AntidotRepository/Quadrirotor/présentation/DIAPO FINAL.pptx

## Réalisation d’un quadricoptère

- Projets tuteurés – Licence Pro Systèmes embarqués

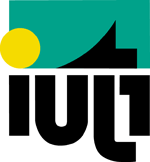
[picture p33: figure]
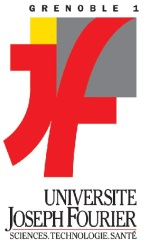
[picture p34: figure]
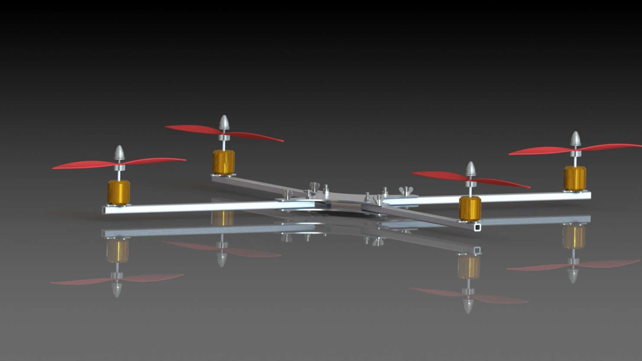
[picture p35: figure]

Harold DUCEPT

2013 - 2014

Lpro SE

## Introduction

1. Comment se déroulent les mini-projets?
  1. Durée de 100h
  2. Travail en autonomie
2. Pourquoi faire un quadricoptère?
  1. Faire du modélisme
  2. Faire quelque chose qui vol
  3. Faire de belles prises de vue
3. Pourquoi le faire pendant les projets tuteurés?
  1. Voué à l’abandon dans le cas contraire
  2. Me permet d’être sur un projet sur lequel je suis motivé

## Sommaire

1. Organisation du système
  1. Les différents sous-ensemble et leur utilité
  2. L’organisation de ces CU à l’aide d’un OS.
2. Etat du système au début du projet tuteuré
  1. Partie PC
  2. Partie Embarquée
3. Avancement
  1. Gyroscope
  2. Altimètre
  3. Moteurs
4. Etat du projet à la fin
  1. Partie PC
  2. Partie embarquée
5. Conclusion

## 1. Organisation du système

- Les différents sous-ensembles

Station sol

DRONE

Système Embarquée

Organisation du système - Les différents sous-ensemble et leur utilité | Etat du système | Avancement | Etat du projet à la fin | Conclusion

## Les différents sous-ensembles

- Station sol

Système réception vidéo

Ecran

Commande

Station sol

Joystick / clavier / souris

XBee

Organisation du système - Les différents sous-ensemble et leur utilité | Etat du système | Avancement | Etat du projet à la fin | Conclusion

## Les différents sous-ensembles

- Partie Embarquée

Batterie

Organisation du système - Les différents sous-ensemble et leur utilité | Etat du système | Avancement | Etat du projet à la fin | Conclusion

µ-contrôleur

Boussole

XBee

PCB

Gyroscope

Altimètre

Variateur

Moteurs

Armature

Partie Embarquée

Partie mécanique

Hélices

Système Vidéo

Caméra

Système émission

Antenne

## Organisation des CUs à l’aide d’un OS

- Pourquoi utiliser un OS?
  - Faire tourner en parallèle des morceaux de code indépendants
  - Avoir une couche d’abstraction matériel
  - Code portable sur tout les microcontrôleurs où le portage de l’OS à été réalisé
- Pourquoi utiliser ChibiOS?
  - Code compatible avec le microcontrôleur que je possède
  - Développé avec un IDE gratuit et que je connais

Organisation du système - L’organisation de ces CU à l’aide d’un OS| Etat du système | Avancement | Etat du projet à la fin | Conclusion

## Organisation des CUs à l’aide d’un OS

ThreadComRcv

ThreadRoulisTangage

ThreadComSnd

Thread principal

ThreadAltitude

ThreadLacet

Organisation du système - L’organisation de ces CU à l’aide d’un OS| Etat du système | Avancement | Etat du projet à la fin | Conclusion

## 2. Etat du système au début du projet

- Partie PC
  - ToDo List:
    - Interface graphique
    - Réception et décodage des trames
    - Codage et envoi des trames
    - Gestion des évènements
    - Recommencer la partie PC…

Organisation du système | Etat du système - Partie PC| Avancement | Etat du projet à la fin | Conclusion

## Etat du système au début du projet

- Partie embarquée
  - ToDo List:
    - Implantation de l’OS
    - Paramétrer un bus I²C
    - Gérer la position du quadricoptère
    - Gérer l’altitude du quadricoptère
    - Réaliser une liaison série sans fil pour envoyer et recevoir des données entre le PC et le quadricoptère
    - Choisir et mettre en place les sorties moteurs
    - Faire une structure et un PCB
    - Rechercher et mettre en place les équations permettant la stabilisation du système
    - Rechercher et mettre en place les équations permettant le filtrage des données

Organisation du système | Etat du système - Partie embarquée| Avancement | Etat du projet à la fin | Conclusion

## 3. Avancement du projet durant les 100h

- Gyroscope
  - Utilité?
    - Permet la gestion du tangage, du roulis et du lacet
  - Modèle choisi
    - MPU-6050 à 2,98€: Gyroscope 6 axes: 3 angles + 3 accélérations
    - Fonctionne sur bus I²C, alimenté en 3,3V ou 5V

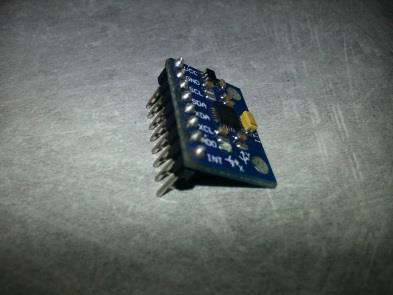
[picture p36: figure]
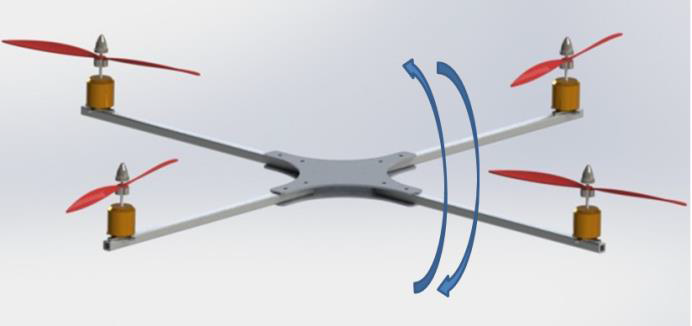
[picture p37: figure]
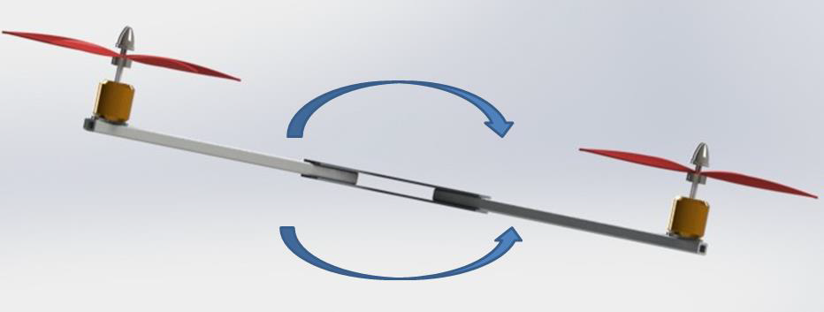
[picture p38: figure]
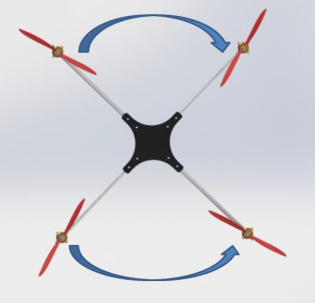
[picture p39: figure]

Organisation du système | Etat du système | Avancement - Gyroscope| Etat du projet à la fin | Conclusion

## Avancement du projet durant les 100h

- Gyroscope
  - Fonctionnement:
  - Conversion de l’angle:

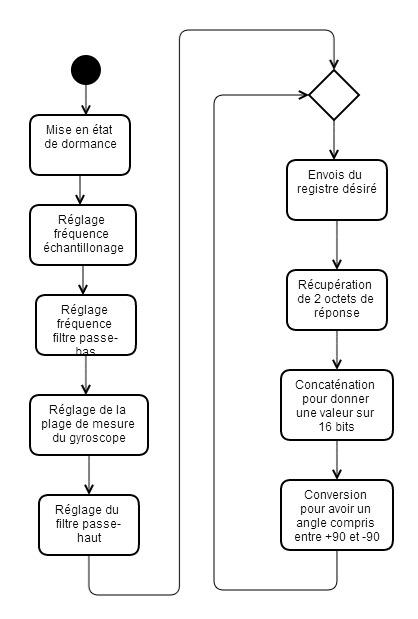
[picture p40: figure]

Si angle compris entre 49151(0xBFFF) et 65535(0xFFFF):
angle en degré= (angle brute −0xBFFF)/(0xB6)−0x5A
Sinon, si angle compris entre 0(0x0000) et 16384(0x4000):
angle en degré= (angle brute)/(0xB6)
Sinon:
angle en degré=0

Organisation du système | Etat du système | Avancement - Gyroscope| Etat du projet à la fin | Conclusion


## Avancement du projet durant les 100h

- Gyroscope
  - Difficultés rencontrées:
    - Paramétrage de l’I²C laborieux
    - Impossible de récupérer un angle de lacet correct.
    - Documentation ne fournissant pas les informations nécessaires.
    - Basé sur un code de démonstration pas forcément bien expliqué (en chinois…)

Organisation du système | Etat du système | Avancement - Gyroscope| Etat du projet à la fin | Conclusion

## Avancement du projet durant les 100h

- Capteur de pression atmosphérique
  - Utilité
    - Connaître l’altitude du quadricoptère en se basant sur la pression atmosphérique.
  - Modèle choisi
    - BMP085 à 9,64€: Capteur de pression atmosphérique d’une précision d’environ 25 cm.
    - Fonctionne sur bus I²C, alimenté en 3,3V ou 5V.

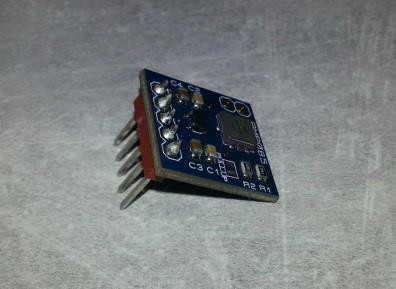
[picture p41: figure]
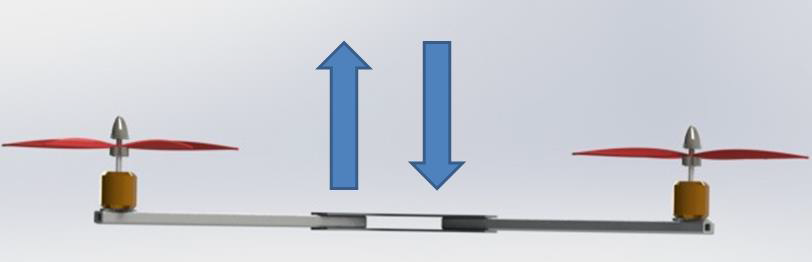
[picture p42: figure]

Organisation du système | Etat du système | Avancement - Altimètre| Etat du projet à la fin | Conclusion

## Avancement du projet durant les 100h

- Capteur de pression atmosphérique
  - Fonctionnement:
  - Difficultés rencontrées
    - Problème d’allocation mémoire avec l’OS
    - Problème optimisation compilateur
    - Algorithme compliqué à mettre en place pour convertir la pression atmosphérique en altitude

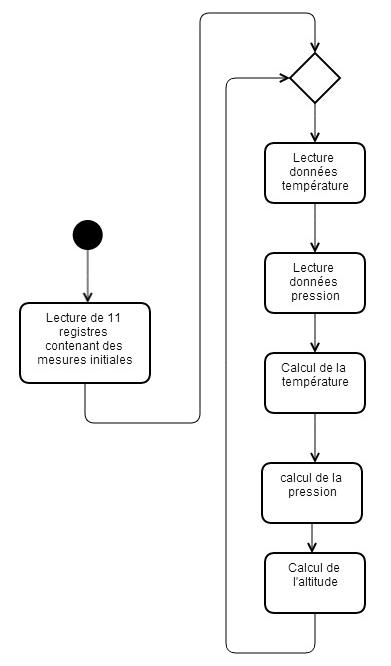
[picture p43: figure]

Organisation du système | Etat du système | Avancement - Altimètre| Etat du projet à la fin | Conclusion

## Avancement du projet durant les 100h

- Moteurs
  - Utilité
    - Les moteurs permettent d’entrainer les hélices.
    - Commandés par le biais de variateurs
  - Modèle choisi
    - Moteurs:
    - Moteurs NTM brushless 1100kv – 20A max – 57g
    - Variateur:
    - Variateur Qbrain 4x25A (4 variateurs dans un seul bloc)
    - Batterie:
    - Batterie LiPo Turnigy 3300mAh 25-50C 4 Cellules – 14,8V
    - Hélices:
    - 10x4,5 pouces: 2 sens horaire, 2 sens trigo

Organisation du système | Etat du système | Avancement - Moteurs| Etat du projet à la fin | Conclusion

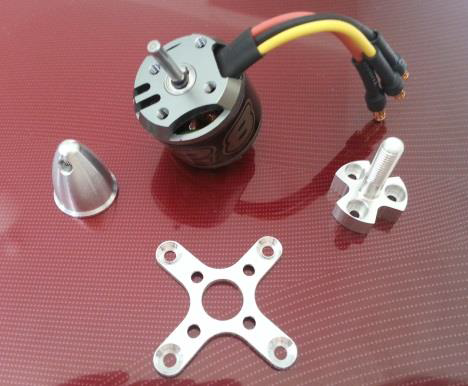
[picture p44: figure]
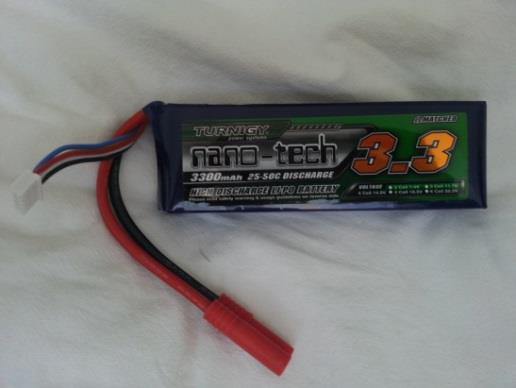
[picture p45: figure]
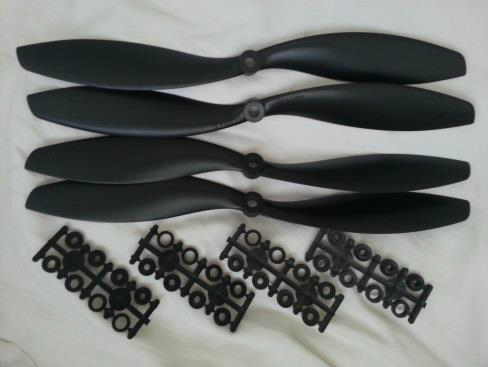
[picture p46: figure]
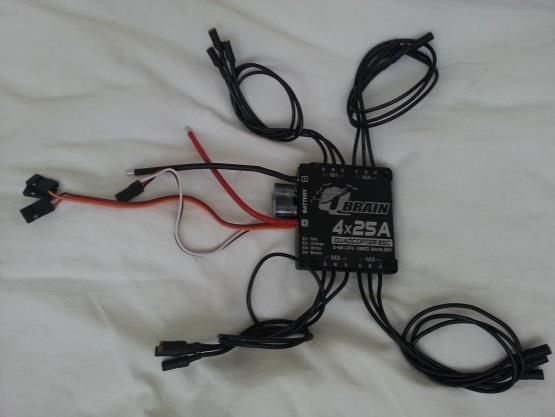
[picture p47: figure]

## Avancement du projet durant les 100h

- Moteurs
  - Hardware:
  - Fonctionnement:
  - Difficultés rencontrées:
    - Absence de documentation concernant le variateur -> compliqué de savoir comment les démarrer.

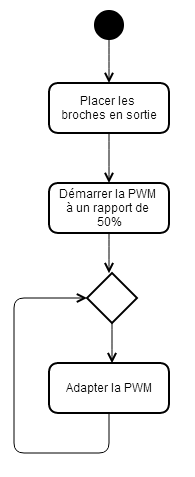
[picture p48: figure]
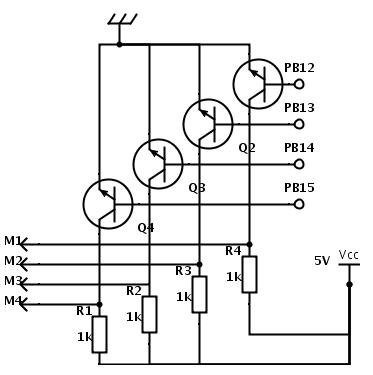
[picture p49: figure]

Organisation du système | Etat du système | Avancement - Moteurs| Etat du projet à la fin | Conclusion

## 3. Etat du projet à la fin des 100h

- Partie PC
  - ToDo List:
    - Interface graphique
    - Réception et décodage des trames
    - Codage et envoi des trames
    - Gestion des évènements
    - Recommencer la partie PC…

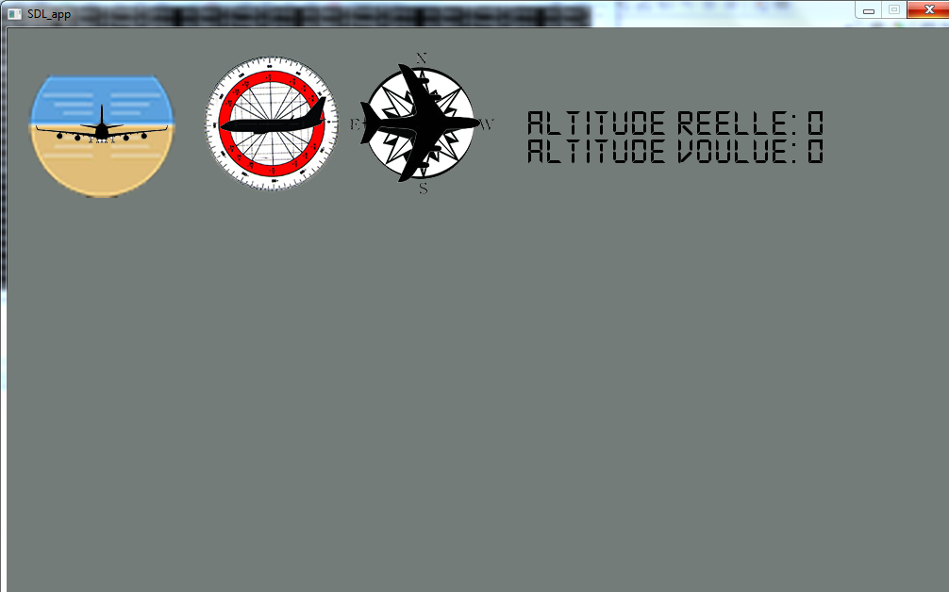
[picture p50: figure]

Organisation du système | Etat du système | Avancement - Moteurs| Etat du projet à la fin – partie PC | Conclusion

## Etat du projet à la fin

- Partie embarquée
  - ToDo List:
    - Implantation de l’OS
    - Paramétrer un bus I²C
    - Gérer la position du quadricoptère
    - Gérer l’altitude du quadricoptère
    - Coder et envoyer sur une liaison série la position du quadricoptère
    - Recevoir et décoder la position désirée du quadricoptère
    - Choisir et mettre en place les sorties moteurs
    - Faire une structure et un PCB
    - Rechercher et mettre en place les équations permettant la stabilisation du système
    - Rechercher et mettre en place les équations permettant le filtrage des données

Organisation du système | Etat du système | Avancement - Moteurs| Etat du projet à la fin – partie embarquée | Conclusion

## Conclusion

- Permis d’avancer sur un projet voué à l’échec dans le cas contraire
- Revoir des notions vues en cours
- Découvrir un nouvel OS
- Développer mes capacités de débogage
- Confirmer mon choix de vouloir travailler dans l’embarqué

Organisation du système | Etat du système | Avancement - Moteurs| Etat du projet à la fin | Conclusion

## Slide 21

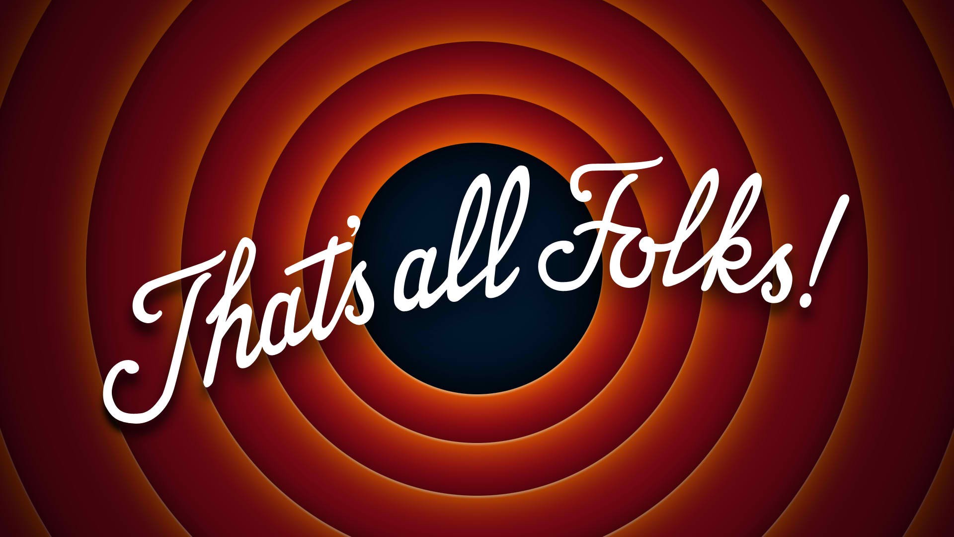
[picture p51: figure]
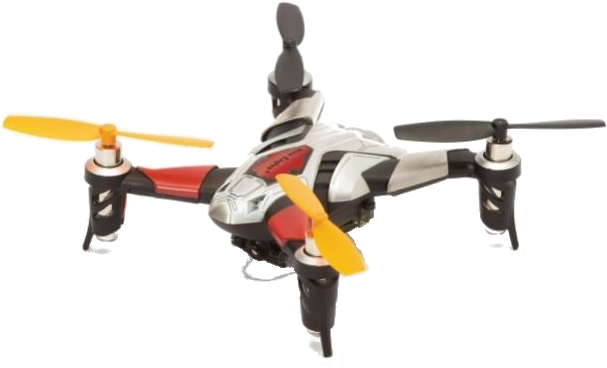
[picture p52: figure]
