AntidotRepository/Quadrirotor/compte rendu/altitude.JPG

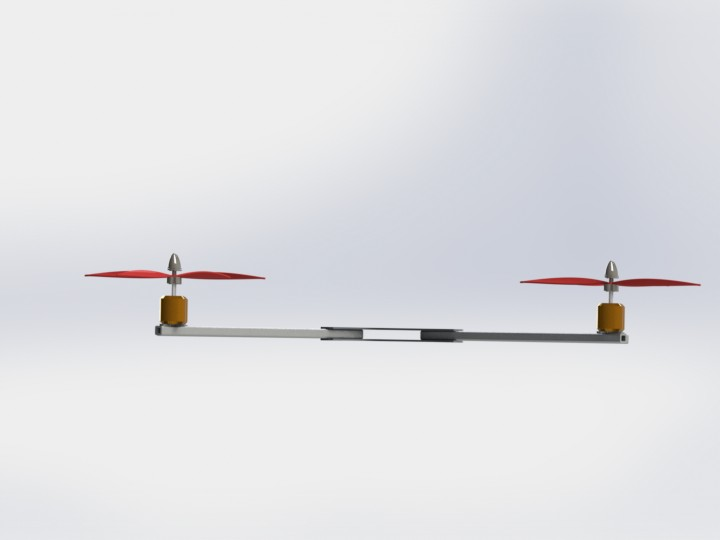
compte rendu/altitude.JPG
