AntidotRepository/Quadrirotor/compte rendu/cu_quadri.jpg

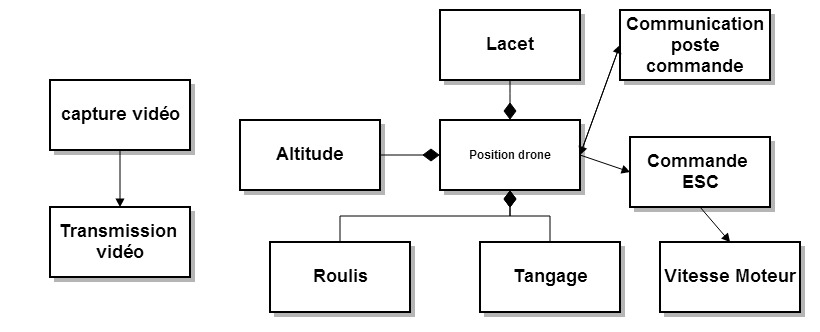
compte rendu/cu_quadri.jpg
