AntidotRepository/Quadrirotor/compte rendu/diagramme déploiement matériel.jpg

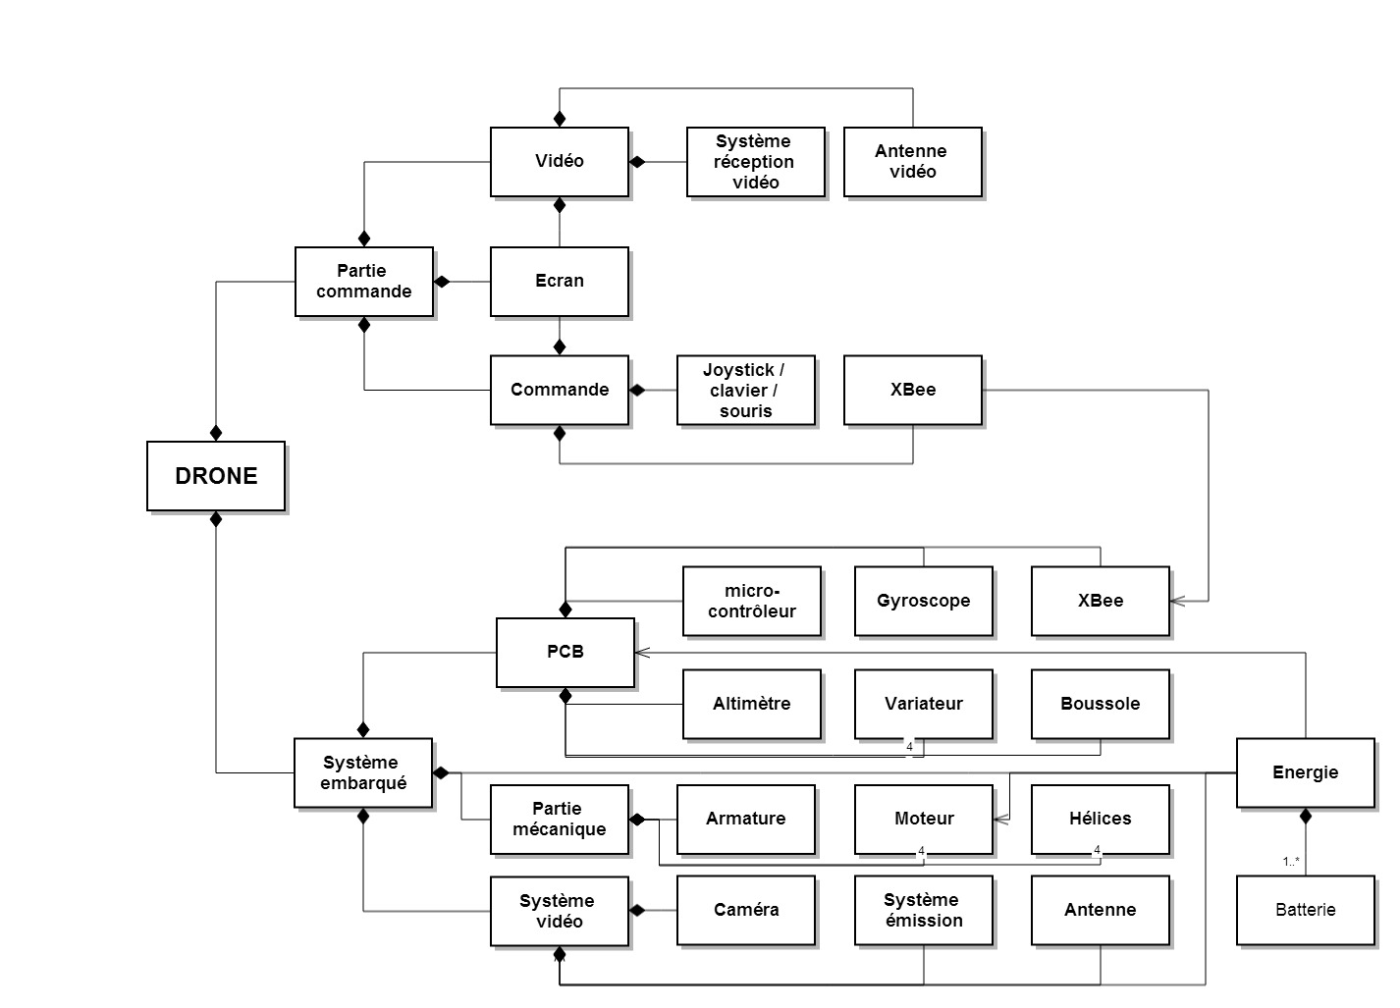
compte rendu/diagramme déploiement matériel.jpg
