AntidotRepository/Quadrirotor/compte rendu/lacet.JPG

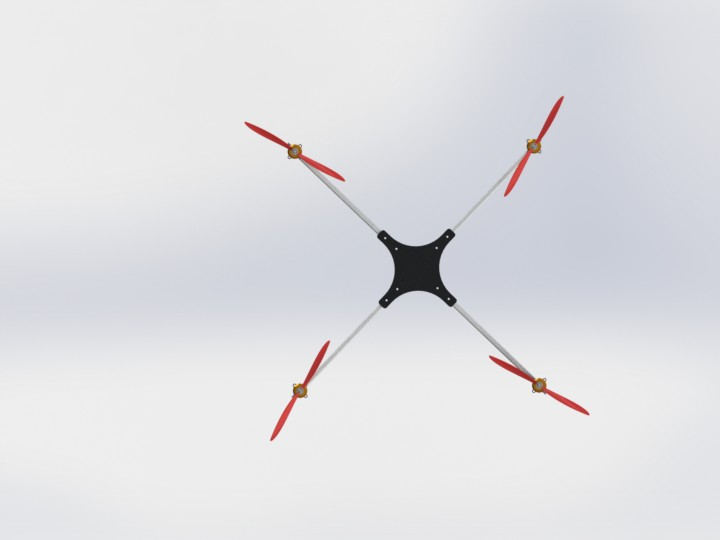
compte rendu/lacet.JPG
