AntidotRepository/Quadrirotor/compte rendu/quad.JPG

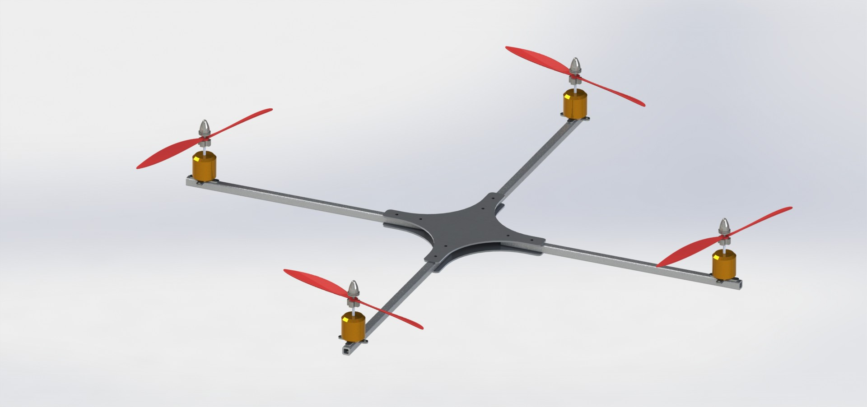
compte rendu/quad.JPG
