AntidotRepository/Quadrirotor/compte rendu/quadri.JPG

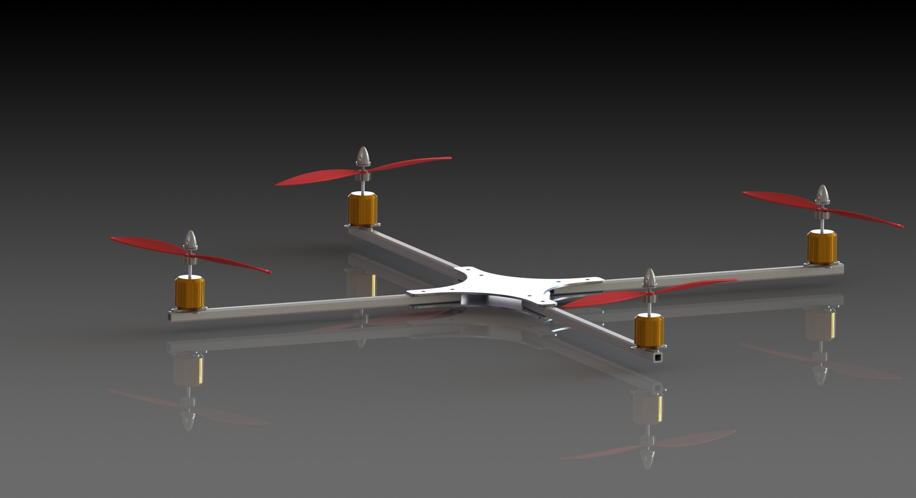
compte rendu/quadri.JPG
