AntidotRepository/Quadrirotor/compte rendu/roulis.JPG

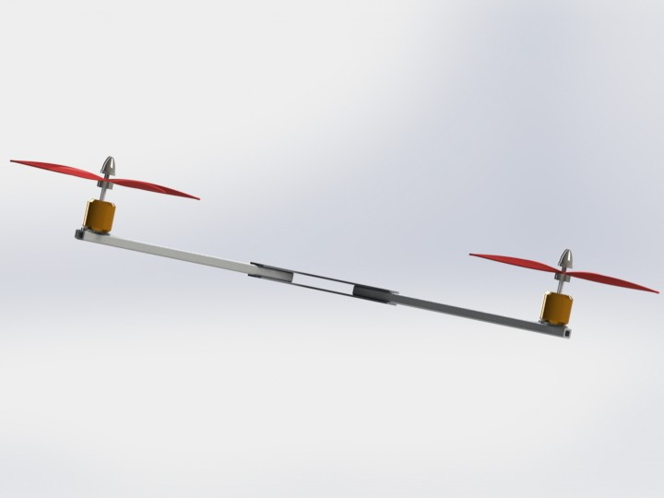
compte rendu/roulis.JPG
