AntidotRepository/Quadrirotor/compte rendu/sequencealti.jpg

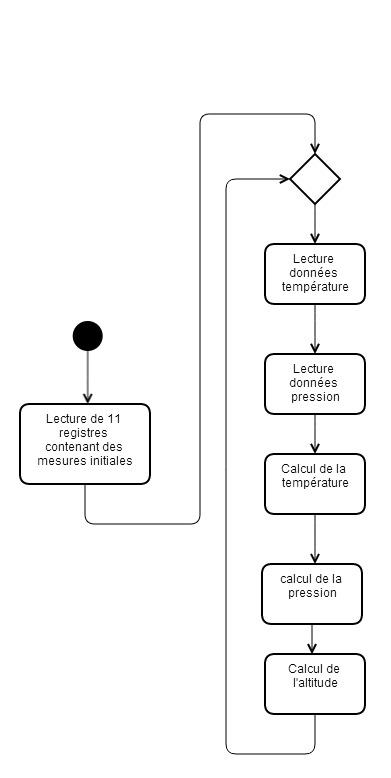
compte rendu/sequencealti.jpg
