AntidotRepository/Quadrirotor/compte rendu/tangage.JPG

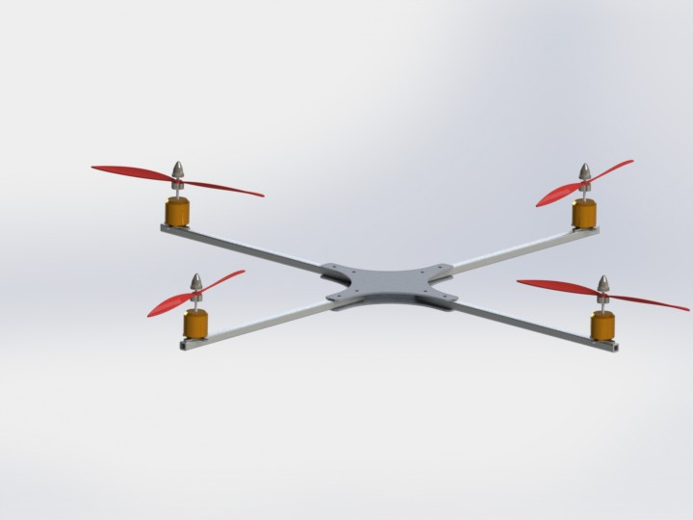
compte rendu/tangage.JPG
