AntidotRepository/Quadrirotor/étude faisabilité.xlsx

Xbee pro? + USB/Xbee adapter
module | Note | P.U. | Qté | Prix total | Frais de ports | référence | Vendeur | Liens
Xbee USB Adapter |  | 12.99 | 1 | 12.99 | 3.68 | Xbee USB Adapter | qqlx_uk | http://www.ebay.fr/itm/Xbee-USB-Adapter-XBee-Explorer-Free-Cable-UK-SELLER-A-446-/320975012358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
Xbee pro série 2 | ATTENTION: QUANTITE 2!!!! | 38.5 | 2 | 77 |  | Module Zigbee XBEE PRO ZNet (Série 2) - Antenne fouet | planete-domotique | http://www.planete-domotique.com/module-zigbee-xbee-pro-znet-serie-2-antenne-fouet.html
gyroscope | contre le roulis et le tangage (déjà acheté) | 7.71 | 1 | 7.71 | 1.51 | 6DOF MPU6050 | Etang_Uk | http://www.ebay.fr/itm/6DOF-MPU6050-3-Axis-Gyroscope-and-Acce-lerometer-Sensor-Module-MultiWii-Arduino-/121142983052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
boussole | contre le lacet | 6.95 | 1 | 6.95 | 1.55 | HMC5883L | rcdistrib | http://compare.ebay.fr/like/280863037681?var=lv&ltyp=AllFixedPriceItemTypes&var=sbar
altimètre |  | 8.1 | 1 | 8.1 | 0.88 | BMP085 | casuntek | http://www.ebay.fr/itm/BMP085-Temperature-Altimeter-Atmospheric-Pressure-Sensor-Board-for-Arduino-DIY-/231013228106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 http://www.ebay.fr/itm/MS5611-Pressure-Barometric-sensor-board-from-MEAS-/280786878092
moteurs | ATTENTION: QUANTITE 4!!!! | 18 | 4 | 72 | 3 | C 2830 1000KV Brushless Motor 230W 7,4 à 14,8 V 20A Parc 400 EMP |  | http://www.ebay.fr/itm/C-2830-1000KV-Brushless-Motor-230W-7-4-14-8V-20A-Park-400-EMP-gold-/170843223470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
hélices | ATTENTION: QUANTITE 2!!!! | 3.46 | 2 | 6.92 | 2.9 | Propellers 10x4.5 | floatship | http://www.ebay.fr/itm/Propellers-pair-of-Cw-CCw-8x4-5-9x4-7-10x4-5-Black-orange-green-quadcopter-UK-/221160144386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
ESC | = contrôleur / Variateur QUANTITE 4!!! | 12 | 4 | 48 | 3 | 20A - 25A ESC Brushless Motor Regler 18g 2A BEC LiPo 7,4-11,1V | schlumpfengel | http://www.ebay.fr/itm/20A-25A-ESC-Brushless-Motor-Regler-18g-2A-BEC-LiPo-7-4-11-1V-/181132172719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
batterie 11,1V | Lipo 3S voir plutôt pour du 4S | 39.99 | 1 | 39.99 | 6.5 | DYN9006EC | millenium modelism | http://www.milleniumrc.fr/dyn9006ec-pack-reaction-11-1v-5000mah-3s-20c.html
 |  | Total | 17 | 279.66 | 23.02
 |  | Total général: |  |  | 302.68
Pour plus tard:
liaison vidéo | Changer antenne pour atteindre 1000m | 99 € | 1 | 99 | ?? | TX/RX 5-8GHZ-200MW | studioSPORT | http://www.studiosport.fr/emetteurrecepteur-58ghz-200mw-p-1971.html
antenne vidéo |  | 34.9 | 1 | 34.9 | ?? | ImmersionRC 5.8GHz Circular Polarized spiroNet Antenna | studioSPORT | http://www.hobbyking.com/hobbyking/store/__27750__5_8GHz_Circular_Polarized_Clover_Leaf_spiroNet_Antenna.html
FPV | First person video | Pilotage avec caméra
Convertisseur 12V 3,3V | TLV 1117 | http://www.ti.com/product/tlv1117
