AntidotRepository/Quadrirotor/SW_Quadri/assemblageQuadri.SLDASM

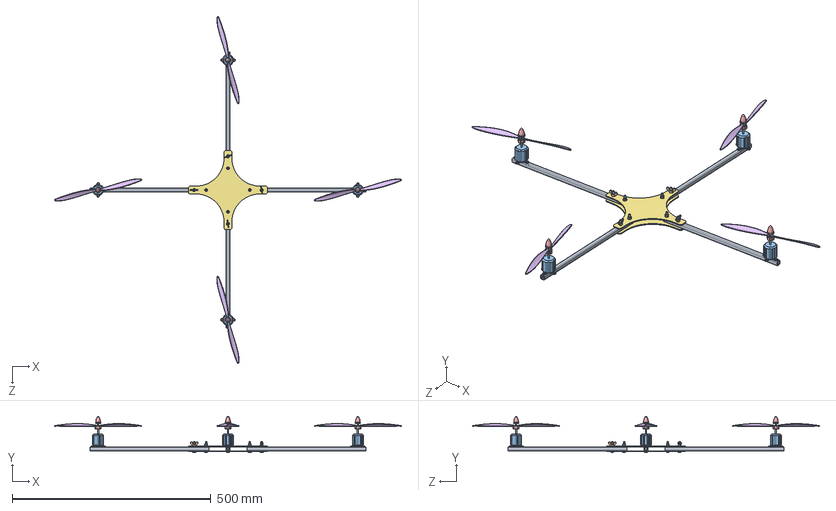
[picture p100: CAD file, 2014-04-05]
SW_Quadri/assemblageQuadri.SLDASM
874.0 x 91.8 x 874.0 mm
bras x 4
croisillonMoteur x 4
corpsMoteur x 4
axeMoteur x 4
chapeauMoteur x 4
hélice x 4
base x 2
hex bolt gradeab_iso x 8
torque nut 01_iso x 4
wing nut 01_din x 4
