AntidotRepository/Quadrirotor/SW_Quadri/base.SLDPRT

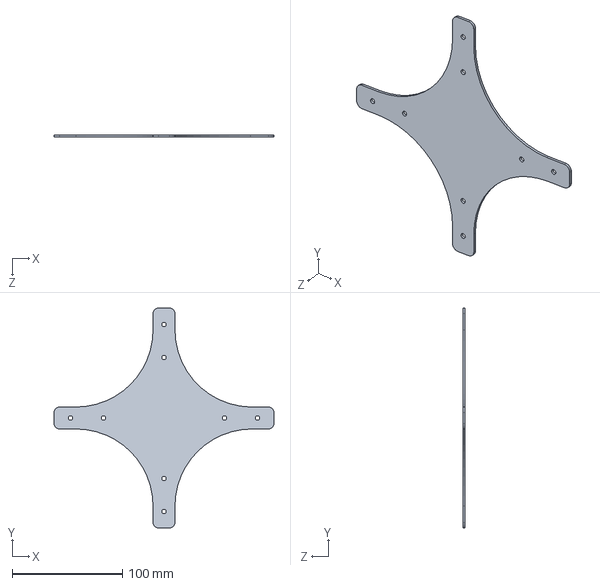
[picture p101: CAD file, 2014-04-05]
SW_Quadri/base.SLDPRT
200.0 x 200.0 x 2.00 mm
