AntidotRepository/Quadrirotor/SW_Quadri/croisillonMoteur.SLDPRT

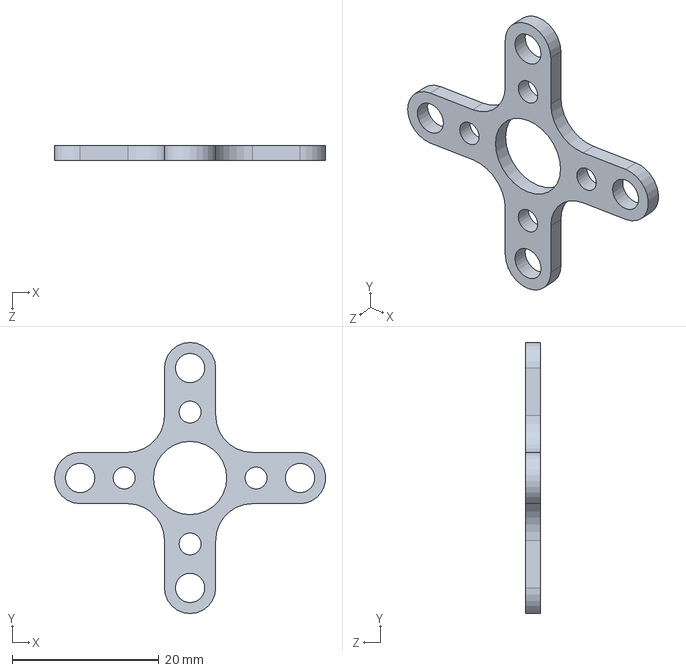
[picture p102: CAD file, 2013-11-25]
SW_Quadri/croisillonMoteur.SLDPRT
37.0 x 37.0 x 2.00 mm
