AntidotRepository/Quadrirotor/SW_Quadri/bras.SLDPRT

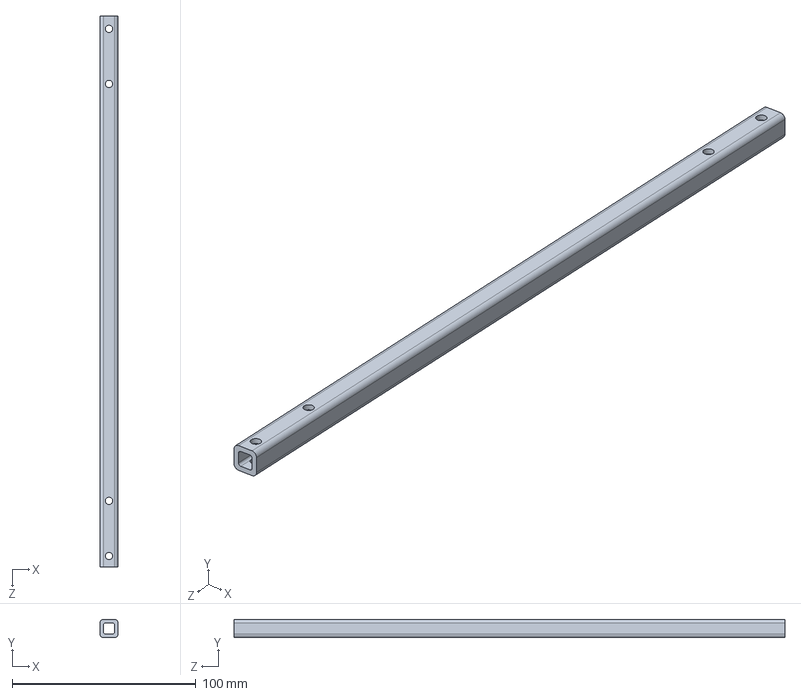
[picture p103: CAD file, 2013-11-25]
SW_Quadri/bras.SLDPRT
10.0 x 10.0 x 300.0 mm
