AntidotRepository/Quadrirotor/SW_Quadri/axeMoteur.SLDPRT

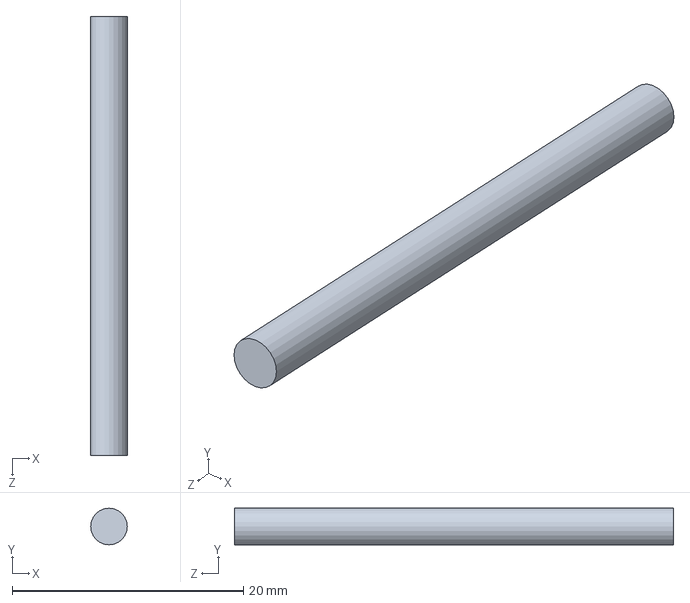
[picture p104: CAD file, 2013-11-25]
SW_Quadri/axeMoteur.SLDPRT
3.17 x 3.17 x 38.0 mm
