AntidotRepository/Quadrirotor/SW_Quadri/corpsMoteur.SLDPRT

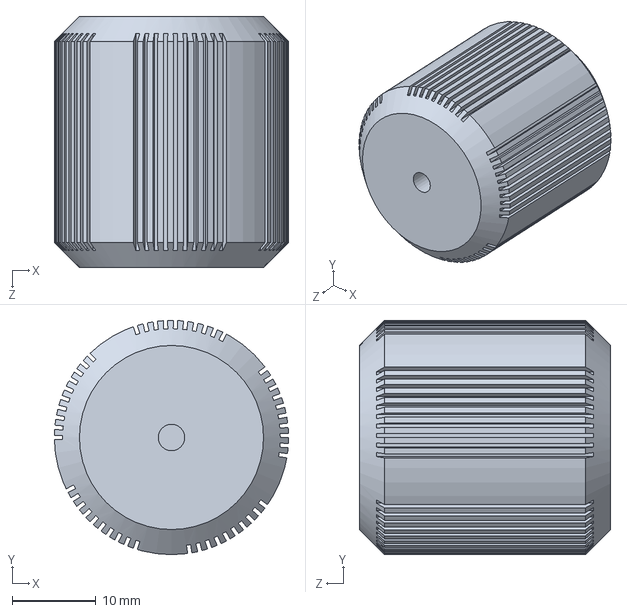
[picture p105: CAD file, 2013-11-25]
SW_Quadri/corpsMoteur.SLDPRT
28.0 x 28.0 x 30.0 mm
