AntidotRepository/Quadrirotor/SW_Quadri/hélice.SLDPRT

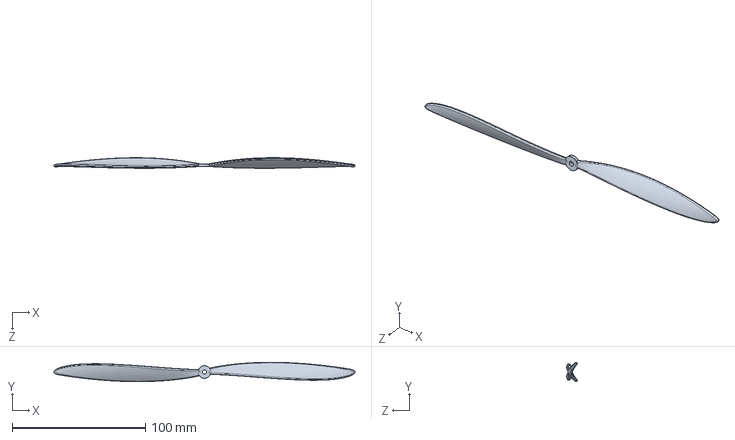
[picture p106: CAD file, 2013-11-25]
SW_Quadri/hélice.SLDPRT
225.7 x 14.5 x 7.96 mm
