AntidotRepository/Quadrirotor/SW_Quadri/chapeauMoteur.SLDPRT

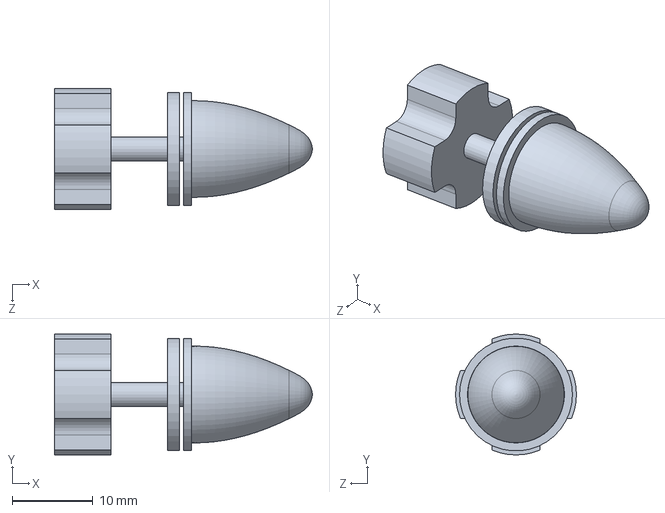
[picture p107: CAD file, 2013-11-25]
SW_Quadri/chapeauMoteur.SLDPRT
32.0 x 15.0 x 15.0 mm
