AntidotRepository/Quadrirotor/Partie PC/QuadricoptèreV4/build-QuadricoptèreV4-Desktop_Qt_5_2_0_MinGW_32bit-Debug/res/AvLacet.png

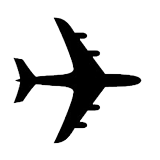
Partie PC/QuadricoptèreV4/build-QuadricoptèreV4-Desktop_Qt_5_2_0_MinGW_32bit-Debug/res/AvLacet.png
