AntidotRepository/Quadrirotor/(list of files, drawings)

Other design files:
schéma.fzz
