AntidotRepository/Quadrirotor/Partie modèle/Code/conf/board.h

/*
    ChibiOS/RT - Copyright (C) 2006-2013 Giovanni Di Sirio

    Licensed under the Apache License, Version 2.0 (the "License");
    you may not use this file except in compliance with the License.
    You may obtain a copy of the License at

        http://www.apache.org/licenses/LICENSE-2.0

    Unless required by applicable law or agreed to in writing, software
    distributed under the License is distributed on an "AS IS" BASIS,
    WITHOUT WARRANTIES OR CONDITIONS OF ANY KIND, either express or implied.
    See the License for the specific language governing permissions and
    limitations under the License.
*/

#ifndef _BOARD_H_
#define _BOARD_H_

/*
 * Setup for ST STM32L-Discovery board.
 */

/*
 * Board identifier.
 */
#define BOARD_ST_STM32L_DISCOVERY
#define BOARD_NAME                  "ST STM32L-Discovery"


/*
 * Board oscillators-related settings.
 * NOTE: HSE not fitted.
 */
#if !defined(STM32_LSECLK)
#define STM32_LSECLK                32768
#endif

#if !defined(STM32_HSECLK)
#define STM32_HSECLK                0
#endif

#define STM32_HSE_BYPASS

/*
* MCU type as defined in the ST header file stm32l1xx.h.
*/
#if !defined(STM32L1XX_MD)
#define STM32L1XX_MD
#endif
/*
 * IO pins assignments.
 */
#define GPIOA_BUTTON                0
#define GPIOA_PIN1                  1
#define GPIOA_PIN2                  2
#define GPIOA_PIN3                  3
#define GPIOA_PIN4                  4
#define GPIOA_PIN5                  5
#define GPIOA_PIN6                  6
#define GPIOA_PIN7                  7
#define GPIOA_PIN8                  8
#define GPIOA_PIN9                  9
#define GPIOA_PIN10                 10
#define GPIOA_PIN11                 11
#define GPIOA_PIN12                 12
#define GPIOA_JTAG_TMS              13
#define GPIOA_JTAG_TCK              14
#define GPIOA_JTAG_TDI              15

#define GPIOB_PIN0                  0
#define GPIOB_PIN1                  1
#define GPIOB_BOOT1                 2
#define GPIOB_JTAG_TDO              3
#define GPIOB_JTAG_TRST             4
#define GPIOB_PIN5                  5
#define GPIOB_LED4                  6
#define GPIOB_LED3                  7
#define GPIOB_PIN8                  8
#define GPIOB_PIN9                  9
#define GPIOB_PIN10                 10
#define GPIOB_PIN11                 11
#define GPIOB_PIN12                 12
#define GPIOB_PIN13                 13
#define GPIOB_PIN14                 14
#define GPIOB_PIN15                 15

#define GPIOC_PIN0                  0
#define GPIOC_PIN1                  1
#define GPIOC_PIN2                  2
#define GPIOC_PIN3                  3
#define GPIOC_PIN4                  4
#define GPIOC_PIN5                  5
#define GPIOC_PIN6                  6
#define GPIOC_PIN7                  7
#define GPIOC_PIN8                  8
#define GPIOC_PIN9                  9
#define GPIOC_PIN10                 10
#define GPIOC_PIN11                 11
#define GPIOC_PIN12                 12
#define GPIOC_PIN13                 13
#define GPIOC_OSC32_IN              14
#define GPIOC_OSC32_OUT             15

#define GPIOD_PIN0                  0
#define GPIOD_PIN1                  1
#define GPIOD_PIN2                  2
#define GPIOD_PIN3                  3
#define GPIOD_PIN4                  4
#define GPIOD_PIN5                  5
#define GPIOD_PIN6                  6
#define GPIOD_PIN7                  7
#define GPIOD_PIN8                  8
#define GPIOD_PIN9                  9
#define GPIOD_PIN10                 10
#define GPIOD_PIN11                 11
#define GPIOD_PIN12                 12
#define GPIOD_PIN13                 13
#define GPIOD_PIN14                 14
#define GPIOD_PIN15                 15

#define GPIOE_PIN0                  0
#define GPIOE_PIN1                  1
#define GPIOE_PIN2                  2
#define GPIOE_PIN3                  3
#define GPIOE_PIN4                  4
#define GPIOE_PIN5                  5
#define GPIOE_PIN6                  6
#define GPIOE_PIN7                  7
#define GPIOE_PIN8                  8
#define GPIOE_PIN9                  9
#define GPIOE_PIN10                 10
#define GPIOE_PIN11                 11
#define GPIOE_PIN12                 12
#define GPIOE_PIN13                 13
#define GPIOE_PIN14                 14
#define GPIOE_PIN15                 15

#define GPIOH_OSC_IN                0
#define GPIOH_OSC_OUT               1
#define GPIOH_PIN2                  2
#define GPIOH_PIN3                  3
#define GPIOH_PIN4                  4
#define GPIOH_PIN5                  5
#define GPIOH_PIN6                  6
#define GPIOH_PIN7                  7
#define GPIOH_PIN8                  8
#define GPIOH_PIN9                  9
#define GPIOH_PIN10                 10
#define GPIOH_PIN11                 11
#define GPIOH_PIN12                 12
#define GPIOH_PIN13                 13
#define GPIOH_PIN14                 14
#define GPIOH_PIN15                 15

/*
 * I/O ports initial setup, this configuration is established soon after reset
 * in the initialization code.
 * Please refer to the STM32 Reference Manual for details.
 */
#define PIN_MODE_INPUT(n)           (0U << ((n) * 2))
#define PIN_MODE_OUTPUT(n)          (1U << ((n) * 2))
#define PIN_MODE_ALTERNATE(n)       (2U << ((n) * 2))
#define PIN_MODE_ANALOG(n)          (3U << ((n) * 2))
#define PIN_ODR_LOW(n)              (0U << (n))
#define PIN_ODR_HIGH(n)             (1U << (n))
#define PIN_OTYPE_PUSHPULL(n)       (0U << (n))
#define PIN_OTYPE_OPENDRAIN(n)      (1U << (n))
#define PIN_OSPEED_400K(n)          (0U << ((n) * 2))
#define PIN_OSPEED_2M(n)            (1U << ((n) * 2))
#define PIN_OSPEED_10M(n)           (2U << ((n) * 2))
#define PIN_OSPEED_40M(n)           (3U << ((n) * 2))
#define PIN_PUPDR_FLOATING(n)       (0U << ((n) * 2))
#define PIN_PUPDR_PULLUP(n)         (1U << ((n) * 2))
#define PIN_PUPDR_PULLDOWN(n)       (2U << ((n) * 2))
#define PIN_AFIO_AF(n, v)           ((v##U) << ((n % 8) * 4))

/*
 * GPIOA setup:
 *
 * PA0  - BUTTON                    (input floating).
 * PA1  - PIN1                      (input pullup).
 * PA2  - PIN2                      (input pullup).
 * PA3  - PIN3                      (input pullup).
 * PA4  - PIN4                      (input pullup).
 * PA5  - PIN5                      (input pullup).
 * PA6  - PIN6                      (input pullup).
 * PA7  - PIN7                      (input pullup).
 * PA8  - PIN8                      (input pullup).
 * PA9  - PIN9                      (input pullup).
 * PA10 - PIN10                     (input pullup).
 * PA11 - PIN11                     (input pullup).
 * PA12 - PIN12                     (input pullup).
 * PA13 - JTAG_TMS                  (alternate 0).
 * PA14 - JTAG_TCK                  (alternate 0).
 * PA15 - JTAG_TDI                  (alternate 0).
 */
#define VAL_GPIOA_MODER             (PIN_MODE_INPUT(GPIOA_BUTTON) |         \
                                     PIN_MODE_INPUT(GPIOA_PIN1) |           \
                                     PIN_MODE_INPUT(GPIOA_PIN2) |           \
                                     PIN_MODE_INPUT(GPIOA_PIN3) |           \
                                     PIN_MODE_INPUT(GPIOA_PIN4) |           \
                                     PIN_MODE_INPUT(GPIOA_PIN5) |           \
                                     PIN_MODE_INPUT(GPIOA_PIN6) |           \
                                     PIN_MODE_INPUT(GPIOA_PIN7) |           \
                                     PIN_MODE_INPUT(GPIOA_PIN8) |           \
                                     PIN_MODE_INPUT(GPIOA_PIN9) |           \
                                     PIN_MODE_INPUT(GPIOA_PIN10) |          \
                                     PIN_MODE_INPUT(GPIOA_PIN11) |          \
                                     PIN_MODE_INPUT(GPIOA_PIN12) |          \
                                     PIN_MODE_ALTERNATE(GPIOA_JTAG_TMS) |   \
                                     PIN_MODE_ALTERNATE(GPIOA_JTAG_TCK) |   \
                                     PIN_MODE_ALTERNATE(GPIOA_JTAG_TDI))
#define VAL_GPIOA_OTYPER            (PIN_OTYPE_PUSHPULL(GPIOA_BUTTON) |     \
                                     PIN_OTYPE_PUSHPULL(GPIOA_PIN1) |       \
                                     PIN_OTYPE_PUSHPULL(GPIOA_PIN2) |       \
                                     PIN_OTYPE_PUSHPULL(GPIOA_PIN3) |       \
                                     PIN_OTYPE_PUSHPULL(GPIOA_PIN4) |       \
                                     PIN_OTYPE_PUSHPULL(GPIOA_PIN5) |       \
                                     PIN_OTYPE_PUSHPULL(GPIOA_PIN6) |       \
                                     PIN_OTYPE_PUSHPULL(GPIOA_PIN7) |       \
                                     PIN_OTYPE_PUSHPULL(GPIOA_PIN8) |       \
                                     PIN_OTYPE_PUSHPULL(GPIOA_PIN9) |       \
                                     PIN_OTYPE_PUSHPULL(GPIOA_PIN10) |      \
                                     PIN_OTYPE_PUSHPULL(GPIOA_PIN11) |      \
                                     PIN_OTYPE_PUSHPULL(GPIOA_PIN12) |      \
                                     PIN_OTYPE_PUSHPULL(GPIOA_JTAG_TMS) |   \
                                     PIN_OTYPE_PUSHPULL(GPIOA_JTAG_TCK) |   \
                                     PIN_OTYPE_PUSHPULL(GPIOA_JTAG_TDI))
#define VAL_GPIOA_OSPEEDR           (PIN_OSPEED_400K(GPIOA_BUTTON) |        \
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
                                     PIN_AFIO_AF(GPIOA_PIN6, 0) |           \
                                     PIN_AFIO_AF(GPIOA_PIN7, 0))
#define VAL_GPIOA_AFRH              (PIN_AFIO_AF(GPIOA_PIN8, 0) |           \
                                     PIN_AFIO_AF(GPIOA_PIN9, 0) |           \
                                     PIN_AFIO_AF(GPIOA_PIN10, 0) |          \
                                     PIN_AFIO_AF(GPIOA_PIN11, 0) |          \
                                     PIN_AFIO_AF(GPIOA_PIN12, 0) |          \
                                     PIN_AFIO_AF(GPIOA_JTAG_TMS, 0) |       \
                                     PIN_AFIO_AF(GPIOA_JTAG_TCK, 0) |       \
                                     PIN_AFIO_AF(GPIOA_JTAG_TDI, 0))

/*
 * GPIOB setup:
 *
 * PB0  - PIN0                      (input pullup).
 * PB1  - PIN1                      (input pullup).
 * PB2  - BOOT1                     (input floating).
 * PB3  - JTAG_TDO                  (alternate 0).
 * PB4  - JTAG_TRST                 (alternate 0).
 * PB5  - PIN5                      (input pullup).
 * PB6  - LED4                      (output pushpull maximum).
 * PB7  - LED3                      (output pushpull maximum).
 * PB8  - PIN8                      (input pullup).
 * PB9  - PIN9                      (input pullup).
 * PB10 - PIN10                     (input pullup).
 * PB11 - PIN11                     (input pullup).
 * PB12 - PIN12                     (input pullup).
 * PB13 - PIN13                     (input pullup).
 * PB14 - PIN14                     (input pullup).
 * PB15 - PIN15                     (input pullup).
 */
#define VAL_GPIOB_MODER             (PIN_MODE_INPUT(GPIOB_PIN0) |           \
                                     PIN_MODE_INPUT(GPIOB_PIN1) |           \
                                     PIN_MODE_INPUT(GPIOB_BOOT1) |          \
                                     PIN_MODE_ALTERNATE(GPIOB_JTAG_TDO) |   \
                                     PIN_MODE_ALTERNATE(GPIOB_JTAG_TRST) |  \
                                     PIN_MODE_INPUT(GPIOB_PIN5) |           \
                                     PIN_MODE_OUTPUT(GPIOB_LED4) |          \
                                     PIN_MODE_OUTPUT(GPIOB_LED3) |          \
                                     PIN_MODE_INPUT(GPIOB_PIN8) |           \
                                     PIN_MODE_INPUT(GPIOB_PIN9) |           \
                                     PIN_MODE_INPUT(GPIOB_PIN10) |          \
                                     PIN_MODE_INPUT(GPIOB_PIN11) |          \
                                     PIN_MODE_INPUT(GPIOB_PIN12) |          \
                                     PIN_MODE_INPUT(GPIOB_PIN13) |          \
                                     PIN_MODE_INPUT(GPIOB_PIN14) |          \
                                     PIN_MODE_INPUT(GPIOB_PIN15))
#define VAL_GPIOB_OTYPER            (PIN_OTYPE_PUSHPULL(GPIOB_PIN0) |       \
                                     PIN_OTYPE_PUSHPULL(GPIOB_PIN1) |       \
                                     PIN_OTYPE_PUSHPULL(GPIOB_BOOT1) |      \
                                     PIN_OTYPE_PUSHPULL(GPIOB_JTAG_TDO) |   \
                                     PIN_OTYPE_PUSHPULL(GPIOB_JTAG_TRST) |  \
                                     PIN_OTYPE_PUSHPULL(GPIOB_PIN5) |       \
                                     PIN_OTYPE_PUSHPULL(GPIOB_LED4) |       \
                                     PIN_OTYPE_PUSHPULL(GPIOB_LED3) |       \
                                     PIN_OTYPE_PUSHPULL(GPIOB_PIN8) |       \
                                     PIN_OTYPE_PUSHPULL(GPIOB_PIN9) |       \
                                     PIN_OTYPE_PUSHPULL(GPIOB_PIN10) |      \
                                     PIN_OTYPE_PUSHPULL(GPIOB_PIN11) |      \
                                     PIN_OTYPE_PUSHPULL(GPIOB_PIN12) |      \
                                     PIN_OTYPE_PUSHPULL(GPIOB_PIN13) |      \
                                     PIN_OTYPE_PUSHPULL(GPIOB_PIN14) |      \
                                     PIN_OTYPE_PUSHPULL(GPIOB_PIN15))
#define VAL_GPIOB_OSPEEDR           (PIN_OSPEED_400K(GPIOB_PIN0) |          \
                                     PIN_OSPEED_400K(GPIOB_PIN1) |          \
                                     PIN_OSPEED_40M(GPIOB_BOOT1) |          \
                                     PIN_OSPEED_40M(GPIOB_JTAG_TDO) |       \
                                     PIN_OSPEED_40M(GPIOB_JTAG_TRST) |      \
                                     PIN_OSPEED_400K(GPIOB_PIN5) |          \
                                     PIN_OSPEED_40M(GPIOB_LED4) |           \
                                     PIN_OSPEED_40M(GPIOB_LED3) |           \
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
                                     PIN_AFIO_AF(GPIOB_PIN13, 0) |          \
                                     PIN_AFIO_AF(GPIOB_PIN14, 0) |          \
                                     PIN_AFIO_AF(GPIOB_PIN15, 0))

/*
 * GPIOC setup:
 *
 * PC0  - PIN0                      (input pullup).
 * PC1  - PIN1                      (input pullup).
 * PC2  - PIN2                      (input pullup).
 * PC3  - PIN3                      (input pullup).
 * PC4  - PIN4                      (input pullup).
 * PC5  - PIN5                      (input pullup).
 * PC6  - PIN6                      (input pullup).
 * PC7  - PIN7                      (input pullup).
 * PC8  - PIN8                      (input pullup).
 * PC9  - PIN9                      (input pullup).
 * PC10 - PIN10                     (input pullup).
 * PC11 - PIN11                     (input pullup).
 * PC12 - PIN12                     (input pullup).
 * PC13 - PIN13                     (input pullup).
 * PC14 - OSC32_IN                  (input floating).
 * PC15 - OSC32_OUT                 (input floating).
 */
#define VAL_GPIOC_MODER             (PIN_MODE_INPUT(GPIOC_PIN0) |           \
                                     PIN_MODE_INPUT(GPIOC_PIN1) |           \
                                     PIN_MODE_INPUT(GPIOC_PIN2) |           \
                                     PIN_MODE_INPUT(GPIOC_PIN3) |           \
                                     PIN_MODE_INPUT(GPIOC_PIN4) |           \
                                     PIN_MODE_INPUT(GPIOC_PIN5) |           \
                                     PIN_MODE_INPUT(GPIOC_PIN6) |           \
                                     PIN_MODE_INPUT(GPIOC_PIN7) |           \
                                     PIN_MODE_INPUT(GPIOC_PIN8) |           \
                                     PIN_MODE_INPUT(GPIOC_PIN9) |           \
                                     PIN_MODE_INPUT(GPIOC_PIN10) |          \
                                     PIN_MODE_INPUT(GPIOC_PIN11) |          \
                                     PIN_MODE_INPUT(GPIOC_PIN12) |          \
                                     PIN_MODE_INPUT(GPIOC_PIN13) |          \
                                     PIN_MODE_INPUT(GPIOC_OSC32_IN) |       \
                                     PIN_MODE_INPUT(GPIOC_OSC32_OUT))
#define VAL_GPIOC_OTYPER            (PIN_OTYPE_PUSHPULL(GPIOC_PIN0) |       \
                                     PIN_OTYPE_PUSHPULL(GPIOC_PIN1) |       \
                                     PIN_OTYPE_PUSHPULL(GPIOC_PIN2) |       \
                                     PIN_OTYPE_PUSHPULL(GPIOC_PIN3) |       \
                                     PIN_OTYPE_PUSHPULL(GPIOC_PIN4) |       \
                                     PIN_OTYPE_PUSHPULL(GPIOC_PIN5) |       \
                                     PIN_OTYPE_PUSHPULL(GPIOC_PIN6) |       \
                                     PIN_OTYPE_PUSHPULL(GPIOC_PIN7) |       \
                                     PIN_OTYPE_PUSHPULL(GPIOC_PIN8) |       \
                                     PIN_OTYPE_PUSHPULL(GPIOC_PIN9) |       \
                                     PIN_OTYPE_PUSHPULL(GPIOC_PIN10) |      \
                                     PIN_OTYPE_PUSHPULL(GPIOC_PIN11) |      \
                                     PIN_OTYPE_PUSHPULL(GPIOC_PIN12) |      \
                                     PIN_OTYPE_PUSHPULL(GPIOC_PIN13) |      \
                                     PIN_OTYPE_PUSHPULL(GPIOC_OSC32_IN) |   \
                                     PIN_OTYPE_PUSHPULL(GPIOC_OSC32_OUT))
#define VAL_GPIOC_OSPEEDR           (PIN_OSPEED_400K(GPIOC_PIN0) |          \
                                     PIN_OSPEED_400K(GPIOC_PIN1) |          \
                                     PIN_OSPEED_400K(GPIOC_PIN2) |          \
                                     PIN_OSPEED_400K(GPIOC_PIN3) |          \
                                     PIN_OSPEED_400K(GPIOC_PIN4) |          \
                                     PIN_OSPEED_400K(GPIOC_PIN5) |          \
                                     PIN_OSPEED_400K(GPIOC_PIN6) |          \
                                     PIN_OSPEED_400K(GPIOC_PIN7) |          \
                                     PIN_OSPEED_400K(GPIOC_PIN8) |          \
                                     PIN_OSPEED_400K(GPIOC_PIN9) |          \
                                     PIN_OSPEED_400K(GPIOC_PIN10) |         \
                                     PIN_OSPEED_400K(GPIOC_PIN11) |         \
                                     PIN_OSPEED_400K(GPIOC_PIN12) |         \
                                     PIN_OSPEED_400K(GPIOC_PIN13) |         \
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
                                     PIN_AFIO_AF(GPIOE_PIN13, 0) |          \
                                     PIN_AFIO_AF(GPIOE_PIN14, 0) |          \
                                     PIN_AFIO_AF(GPIOE_PIN15, 0))

/*
 * GPIOH setup:
 *
 * PH0  - OSC_IN                    (input floating).
 * PH1  - OSC_OUT                   (input floating).
 * PH2  - PIN2                      (input pullup).
 * PH3  - PIN3                      (input pullup).
 * PH4  - PIN4                      (input pullup).
 * PH5  - PIN5                      (input pullup).
 * PH6  - PIN6                      (input pullup).
 * PH7  - PIN7                      (input pullup).
 * PH8  - PIN8                      (input pullup).
 * PH9  - PIN9                      (input pullup).
 * PH10 - PIN10                     (input pullup).
 * PH11 - PIN11                     (input pullup).
 * PH12 - PIN12                     (input pullup).
 * PH13 - PIN13                     (input pullup).
 * PH14 - PIN14                     (input pullup).
 * PH15 - PIN15                     (input pullup).
 */
#define VAL_GPIOH_MODER             (PIN_MODE_INPUT(GPIOH_OSC_IN) |         \
                                     PIN_MODE_INPUT(GPIOH_OSC_OUT) |        \
                                     PIN_MODE_INPUT(GPIOH_PIN2) |           \
                                     PIN_MODE_INPUT(GPIOH_PIN3) |           \
                                     PIN_MODE_INPUT(GPIOH_PIN4) |           \
                                     PIN_MODE_INPUT(GPIOH_PIN5) |           \
                                     PIN_MODE_INPUT(GPIOH_PIN6) |           \
                                     PIN_MODE_INPUT(GPIOH_PIN7) |           \
                                     PIN_MODE_INPUT(GPIOH_PIN8) |           \
                                     PIN_MODE_INPUT(GPIOH_PIN9) |           \
                                     PIN_MODE_INPUT(GPIOH_PIN10) |          \
                                     PIN_MODE_INPUT(GPIOH_PIN11) |          \
                                     PIN_MODE_INPUT(GPIOH_PIN12) |          \
                                     PIN_MODE_INPUT(GPIOH_PIN13) |          \
                                     PIN_MODE_INPUT(GPIOH_PIN14) |          \
                                     PIN_MODE_INPUT(GPIOH_PIN15))
#define VAL_GPIOH_OTYPER            (PIN_OTYPE_PUSHPULL(GPIOH_OSC_IN) |     \
                                     PIN_OTYPE_PUSHPULL(GPIOH_OSC_OUT) |    \
                                     PIN_OTYPE_PUSHPULL(GPIOH_PIN2) |       \
                                     PIN_OTYPE_PUSHPULL(GPIOH_PIN3) |       \
                                     PIN_OTYPE_PUSHPULL(GPIOH_PIN4) |       \
                                     PIN_OTYPE_PUSHPULL(GPIOH_PIN5) |       \
                                     PIN_OTYPE_PUSHPULL(GPIOH_PIN6) |       \
                                     PIN_OTYPE_PUSHPULL(GPIOH_PIN7) |       \
                                     PIN_OTYPE_PUSHPULL(GPIOH_PIN8) |       \
                                     PIN_OTYPE_PUSHPULL(GPIOH_PIN9) |       \
                                     PIN_OTYPE_PUSHPULL(GPIOH_PIN10) |      \
                                     PIN_OTYPE_PUSHPULL(GPIOH_PIN11) |      \
                                     PIN_OTYPE_PUSHPULL(GPIOH_PIN12) |      \
                                     PIN_OTYPE_PUSHPULL(GPIOH_PIN13) |      \
                                     PIN_OTYPE_PUSHPULL(GPIOH_PIN14) |      \
                                     PIN_OTYPE_PUSHPULL(GPIOH_PIN15))
#define VAL_GPIOH_OSPEEDR           (PIN_OSPEED_40M(GPIOH_OSC_IN) |         \
                                     PIN_OSPEED_40M(GPIOH_OSC_OUT) |        \
                                     PIN_OSPEED_400K(GPIOH_PIN2) |          \
                                     PIN_OSPEED_400K(GPIOH_PIN3) |          \
                                     PIN_OSPEED_400K(GPIOH_PIN4) |          \
                                     PIN_OSPEED_400K(GPIOH_PIN5) |          \
                                     PIN_OSPEED_400K(GPIOH_PIN6) |          \
                                     PIN_OSPEED_400K(GPIOH_PIN7) |          \
                                     PIN_OSPEED_400K(GPIOH_PIN8) |          \
                                     PIN_OSPEED_400K(GPIOH_PIN9) |          \
                                     PIN_OSPEED_400K(GPIOH_PIN10) |         \
                                     PIN_OSPEED_400K(GPIOH_PIN11) |         \
                                     PIN_OSPEED_400K(GPIOH_PIN12) |         \
                                     PIN_OSPEED_400K(GPIOH_PIN13) |         \
                                     PIN_OSPEED_400K(GPIOH_PIN14) |         \
                                     PIN_OSPEED_400K(GPIOH_PIN15))
#define VAL_GPIOH_PUPDR             (PIN_PUPDR_FLOATING(GPIOH_OSC_IN) |     \
                                     PIN_PUPDR_FLOATING(GPIOH_OSC_OUT) |    \
                                     PIN_PUPDR_PULLUP(GPIOH_PIN2) |         \
                                     PIN_PUPDR_PULLUP(GPIOH_PIN3) |         \
                                     PIN_PUPDR_PULLUP(GPIOH_PIN4) |         \
                                     PIN_PUPDR_PULLUP(GPIOH_PIN5) |         \
                                     PIN_PUPDR_PULLUP(GPIOH_PIN6) |         \
                                     PIN_PUPDR_PULLUP(GPIOH_PIN7) |         \
                                     PIN_PUPDR_PULLUP(GPIOH_PIN8) |         \
                                     PIN_PUPDR_PULLUP(GPIOH_PIN9) |         \
                                     PIN_PUPDR_PULLUP(GPIOH_PIN10) |        \
                                     PIN_PUPDR_PULLUP(GPIOH_PIN11) |        \
                                     PIN_PUPDR_PULLUP(GPIOH_PIN12) |        \
                                     PIN_PUPDR_PULLUP(GPIOH_PIN13) |        \
                                     PIN_PUPDR_PULLUP(GPIOH_PIN14) |        \
                                     PIN_PUPDR_PULLUP(GPIOH_PIN15))
#define VAL_GPIOH_ODR               (PIN_ODR_HIGH(GPIOH_OSC_IN) |           \
                                     PIN_ODR_HIGH(GPIOH_OSC_OUT) |          \
                                     PIN_ODR_HIGH(GPIOH_PIN2) |             \
                                     PIN_ODR_HIGH(GPIOH_PIN3) |             \
                                     PIN_ODR_HIGH(GPIOH_PIN4) |             \
                                     PIN_ODR_HIGH(GPIOH_PIN5) |             \
                                     PIN_ODR_HIGH(GPIOH_PIN6) |             \
                                     PIN_ODR_HIGH(GPIOH_PIN7) |             \
                                     PIN_ODR_HIGH(GPIOH_PIN8) |             \
                                     PIN_ODR_HIGH(GPIOH_PIN9) |             \
                                     PIN_ODR_HIGH(GPIOH_PIN10) |            \
                                     PIN_ODR_HIGH(GPIOH_PIN11) |            \
                                     PIN_ODR_HIGH(GPIOH_PIN12) |            \
                                     PIN_ODR_HIGH(GPIOH_PIN13) |            \
                                     PIN_ODR_HIGH(GPIOH_PIN14) |            \
                                     PIN_ODR_HIGH(GPIOH_PIN15))
#define VAL_GPIOH_AFRL              (PIN_AFIO_AF(GPIOH_OSC_IN, 0) |         \
                                     PIN_AFIO_AF(GPIOH_OSC_OUT, 0) |        \
                                     PIN_AFIO_AF(GPIOH_PIN2, 0) |           \
                                     PIN_AFIO_AF(GPIOH_PIN3, 0) |           \
                                     PIN_AFIO_AF(GPIOH_PIN4, 0) |           \
                                     PIN_AFIO_AF(GPIOH_PIN5, 0) |           \
                                     PIN_AFIO_AF(GPIOH_PIN6, 0) |           \
                                     PIN_AFIO_AF(GPIOH_PIN7, 0))
#define VAL_GPIOH_AFRH              (PIN_AFIO_AF(GPIOH_PIN8, 0) |           \
                                     PIN_AFIO_AF(GPIOH_PIN9, 0) |           \
                                     PIN_AFIO_AF(GPIOH_PIN10, 0) |          \
                                     PIN_AFIO_AF(GPIOH_PIN11, 0) |          \
                                     PIN_AFIO_AF(GPIOH_PIN12, 0) |          \
                                     PIN_AFIO_AF(GPIOH_PIN13, 0) |          \
                                     PIN_AFIO_AF(GPIOH_PIN14, 0) |          \
                                     PIN_AFIO_AF(GPIOH_PIN15, 0))


#if !defined(_FROM_ASM_)
#ifdef __cplusplus
extern "C" {
#endif
  void boardInit(void);
#ifdef __cplusplus
}
#endif
#endif /* _FROM_ASM_ */

#endif /* _BOARD_H_ */
