AntidotRepository/Quadrirotor/Partie modèle/Code/os/ports/GCC/PPC/SPC560BCxx/ppcparams.h

/*
    ChibiOS/RT - Copyright (C) 2006,2007,2008,2009,2010,
                 2011,2012,2013 Giovanni Di Sirio.

    This file is part of ChibiOS/RT.

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
                                      ---

    A special exception to the GPL can be applied should you wish to distribute
    a combined work that includes ChibiOS/RT, without being obliged to provide
    the source code for any proprietary components. See the file exception.txt
    for full details of how and when the exception can be applied.
*/

/**
 * @file    SPC560BCxx/ppcparams.h
 * @brief   PowerPC parameters for the SPC560B/Cxx.
 *
 * @defgroup PPC_SPC560BCxx SPC560BCxx Specific Parameters
 * @ingroup PPC_SPECIFIC
 * @details This file contains the PowerPC specific parameters for the
 *          SPC560BCxx platform.
 * @{
 */

#ifndef _PPCPARAMS_H_
#define _PPCPARAMS_H_

/**
 * @brief   PPC core model.
 */
#define PPC_VARIANT                 PPC_VARIANT_e200z0

/**
 * @brief   Number of writable bits in IVPR register.
 */
#define PPC_IVPR_BITS               20

/**
 * @brief   IVORx registers support.
 */
#define PPC_SUPPORTS_IVORS          FALSE

/**
 * @brief   Book E instruction set support.
 */
#define PPC_SUPPORTS_BOOKE          FALSE

/**
 * @brief   VLE instruction set support.
 */
#define PPC_SUPPORTS_VLE            TRUE

/**
 * @brief   Supports VLS Load/Store Multiple Volatile instructions.
 */
#define PPC_SUPPORTS_VLE_MULTI      TRUE

/**
 * @brief   Supports the decrementer timer.
 */
#define PPC_SUPPORTS_DECREMENTER    FALSE

#endif /* _PPCPARAMS_H_ */

/** @} */
