AntidotRepository/Quadrirotor/Partie modèle/Code/os/hal/src/serial_usb.c

/*
    ChibiOS/RT - Copyright (C) 2006,2007,2008,2009,2010,
                 2011,2012,2013 Giovanni Di Sirio.

    This file is part of ChibiOS/RT.

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
                                      ---

    A special exception to the GPL can be applied should you wish to distribute
    a combined work that includes ChibiOS/RT, without being obliged to provide
    the source code for any proprietary components. See the file exception.txt
    for full details of how and when the exception can be applied.
*/

/**
 * @file    serial_usb.c
 * @brief   Serial over USB Driver code.
 *
 * @addtogroup SERIAL_USB
 * @{
 */

#include "ch.h"
#include "hal.h"

#if HAL_USE_SERIAL_USB || defined(__DOXYGEN__)

/*===========================================================================*/
/* Driver local definitions.                                                 */
/*===========================================================================*/

/*===========================================================================*/
/* Driver exported variables.                                                */
/*===========================================================================*/

/*===========================================================================*/
/* Driver local variables and types.                                         */
/*===========================================================================*/

/*
 * Current Line Coding.
 */
static cdc_linecoding_t linecoding = {
  {0x00, 0x96, 0x00, 0x00},             /* 38400.                           */
  LC_STOP_1, LC_PARITY_NONE, 8
};

/*===========================================================================*/
/* Driver local functions.                                                   */
/*===========================================================================*/

/*
 * Interface implementation.
 */

static size_t write(void *ip, const uint8_t *bp, size_t n) {

  return chOQWriteTimeout(&((SerialUSBDriver *)ip)->oqueue, bp,
                          n, TIME_INFINITE);
}

static size_t read(void *ip, uint8_t *bp, size_t n) {

  return chIQReadTimeout(&((SerialUSBDriver *)ip)->iqueue, bp,
                         n, TIME_INFINITE);
}

static msg_t put(void *ip, uint8_t b) {

  return chOQPutTimeout(&((SerialUSBDriver *)ip)->oqueue, b, TIME_INFINITE);
}

static msg_t get(void *ip) {

  return chIQGetTimeout(&((SerialUSBDriver *)ip)->iqueue, TIME_INFINITE);
}

static msg_t putt(void *ip, uint8_t b, systime_t timeout) {

  return chOQPutTimeout(&((SerialUSBDriver *)ip)->oqueue, b, timeout);
}

static msg_t gett(void *ip, systime_t timeout) {

  return chIQGetTimeout(&((SerialUSBDriver *)ip)->iqueue, timeout);
}

static size_t writet(void *ip, const uint8_t *bp, size_t n, systime_t time) {

  return chOQWriteTimeout(&((SerialUSBDriver *)ip)->oqueue, bp, n, time);
}

static size_t readt(void *ip, uint8_t *bp, size_t n, systime_t time) {

  return chIQReadTimeout(&((SerialUSBDriver *)ip)->iqueue, bp, n, time);
}

static const struct SerialUSBDriverVMT vmt = {
  write, read, put, get,
  putt, gett, writet, readt
};

/**
 * @brief   Notification of data removed from the input queue.
 */
static void inotify(GenericQueue *qp) {
  size_t n, maxsize;
  SerialUSBDriver *sdup = chQGetLink(qp);

  /* If the USB driver is not in the appropriate state then transactions
     must not be started.*/
  if ((usbGetDriverStateI(sdup->config->usbp) != USB_ACTIVE) ||
      (sdup->state != SDU_READY))
    return;

  /* If there is in the queue enough space to hold at least one packet and
     a transaction is not yet started then a new transaction is started for
     the available space.*/
  maxsize = sdup->config->usbp->epc[sdup->config->bulk_out]->out_maxsize;
  if (!usbGetReceiveStatusI(sdup->config->usbp, sdup->config->bulk_out) &&
      ((n = chIQGetEmptyI(&sdup->iqueue)) >= maxsize)) {
    chSysUnlock();

    n = (n / maxsize) * maxsize;
    usbPrepareQueuedReceive(sdup->config->usbp,
                            sdup->config->bulk_out,
                            &sdup->iqueue, n);

    chSysLock();
    usbStartReceiveI(sdup->config->usbp, sdup->config->bulk_out);
  }
}
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
