AntidotRepository/Quadrirotor/(commit log)

2013-11-07 Revert "Ajout initialisation altimètre"
    This reverts commit a227f2422af63326c7cb87adf8f8a3d0e67396ed.
    [main.c]
2013-11-25 Ajout gestion altitude Vérifier précision des valeurs (troncature?)
    [assemblageQuadri.SLDASM, axeMoteur.SLDPRT, base.SLDPRT, bras.SLDPRT, chapeauMoteur.SLDPRT, corpsMoteur.SLDPRT, croisillonMoteur.SLDPRT, hélice.SLDPRT]
2013-11-27 Revert "Mise au propre du code."
    This reverts commit 5b473845ebd5dd319b8d00662f30785dc2b6b51f.
    [main.c]
2014-01-07 Ajout de la gestion des moteurs
    [Dimensionnement moteur.xls]
2014-04-05 Reprise de 0 du code partie embarquée: - Création d'un projet propre - Organisation du code dans des fichiers séparés
    [assemblageQuadri.SLDASM, base.SLDPRT, organisationCode.xlsx]
2014-04-11 Finalisation calcul PWM moteurs comprise entre 0 et 100% au lieu de 50 et 100%
2014-04-12 Correction bugs moteurs + communication sans fil
    [XBee.c, XBee.h, main.c, motor.c]
2014-05-26 Ajout de la réception des données.
2014-09-27 Gestion altitude (précision à + ou - 1 mètre) Reprise code gyroscope Réorganisation projet
